headrotor/cm2/docs/cm2-render-big.png

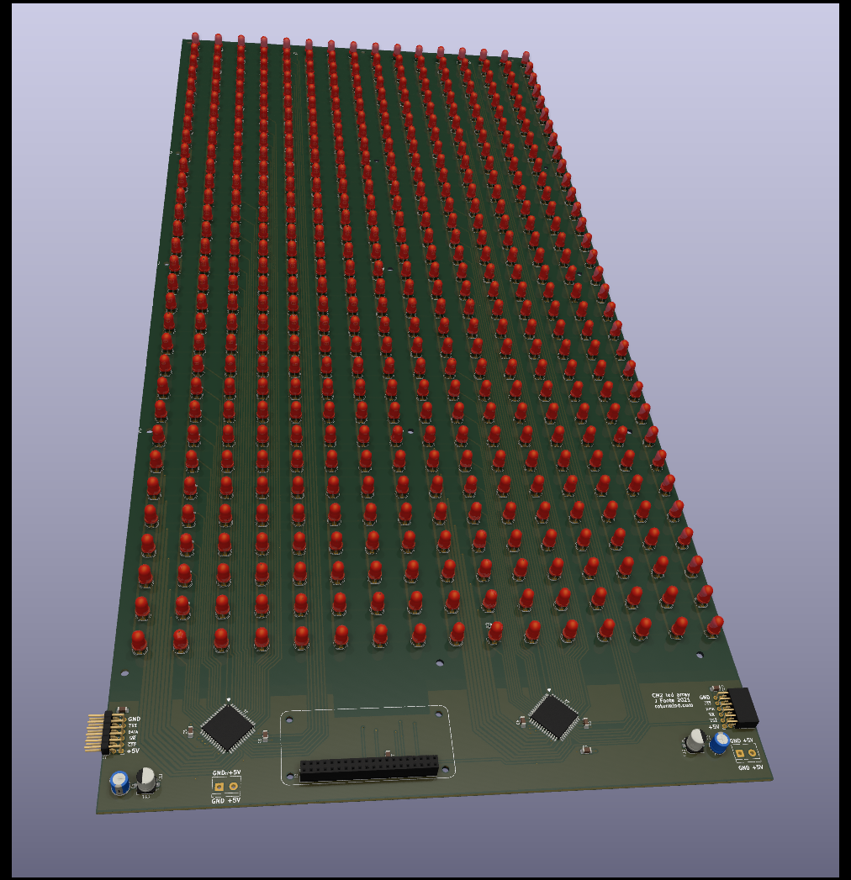
docs/cm2-render-big.png
