headrotor/cm2/README.md

# cm2
Design files for Connection Machine-inspired LED panel
