headrotor/cm2/docs/README.md

# cm2
Documentation files for Connection Machine-inspired LED panel

* `cm2-BOM.*`: Bill Of Materials, list of all parts necessary
* `cm2-pcb.pdf`  PDF of printed circuit board layout         
* `cm2-render.*` 3D renderings of printed circuit board with componentys    
* `pcb-cad-2D.dxf`  DXF of board outline with mounting holes
* `cm2-schematic.pdf` Board schematic in PDF format
* `cm2-dimensions.pdf`: Rendering of PCB with dimensions
* `ht1632cv120.pdf`: Data sheet of LED driver IC
