headrotor/cm2/sw/README.md

## CM2 panel Python software

Low-level driver code for the RPI is in `htlib` directory. See the README there. That code is compiled for the library `libht1632c-py.so` which must be in this directory or in the python load path. 

Several test programs exist to excercise the CM2 display panel. 'setxy.py' turns on a pixel at x and y, for example to turn on a pixel at x=10 and y=11 type:

```console
$ python setxy.py 10 11
```

## The CM2 HTTP Server

`cm2_server.py` drives the display by running an http server at port
8000 and responding to query strings in the URL of a GET request. Several command line options are available:

```
  -h, --help         show this help message and exit
  --silent           don't print anything to stdout
  --simulate         print a simulated screen to stdout
  --flip_horizontal  reverse horizontal direction, x=0 is at right
  --swap_xy          swap x and y directions, y is horizontal, x is vertical
  --flip_vertical    reverse vertical direction, y=0 is at bottom
```

To send a frame of data, send 128 characters of hexadecimal data in
column-major order with the `frame` query parameter.

Each 8 hex characters represent 32 bits in one column of LEDs. For
example the following curl command will send data to light the
leftmost and rightmost columns and top and bottom rows, drawing a box
around the perimeter of the display.

```console
$ curl -s 'http://cm2.local:8000/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'
```

Other query parameters are:

* `?bright=n` sets the PWM brightness where `n` is an integer between 0
  and 15.

* `?x=10&y=11&font=8x12&text=HELLO%20WORLD` will display the text
  "HELLO WORLD" (use URL string encoding) at position x=10 and y=11,
  using the `8x12` pixel font. If the `x` and `y` parameters are not
  specified the default position of zero (top left corner) is
  used. Negative positions can be used so that decrementing the `x`
  position will scroll the text left to right so that text wider than
  32 pixels can be displayed sequentially.

* `?clear=0` clears the display. This can be used with the `text`
  query to display text on a blank background. Note this only works with 
  the `text` command; to clear the display completely, send a `clear=0` 
  together with `text=%20` (space).

Several fonts are available, specified by character size as follows:

* 3x4num
* 4x5num
* 7x8num
* 4x6
* 4x6sym
* 5x8
* 6x8
* 7x12
* 8x12
* 12x16

A suffix of 'num' means that only numeric characters are available,
alphabetic characters will be rendered as an open rectangle. The font
selected by the `font` command is persistant and further `text`
commands will be rendered in that font.

As usual, multiple parameters may be used in one command, for example
the following command will display text at 10, 10 with a brightness of
25% on a dark background. 

```console
$ curl -s 'http://cm2.local:8000/?clear=0&x=10&y=10&bright=4&&text=Hello%20World'
```

### OSC_SERVER

A server using Open Sound Control uses UDP instead of HTTP and can be much faster (at the cost of missing frames).

This depends on https://pypi.org/project/python-osc/ and runs under python3.
python3 -m pip install python-osc
