headrotor/cm2/docs/cm2-BOM.xlsx

Ref | Qnty | Value | Description | Part Number/source | URL | Notes | Footprint | Description | Vendor
C1, C2 | 2 | 100uF | C_Polarized_Small_US |  |  | Alternate footprints: Only need C1 and C2 OR C11 and C12 | Capacitor_THT:CP_Radial_D6.3mm_P2.50mm | Polarized capacitor, small US symbol
C3, C4, C5, C6, C7, C8, C9, C10 | 8 | 1uF | CAP CER 1UF 25V X7R 1206 | CC1206KKX7R8BB105 | https://www.digikey.com/en/products/detail/yageo/CC1206KKX7R8BB105/2103094 |  | Capacitor_SMD:C_1206_3216Metric_Pad1.33x1.80mm_HandSolder | Unpolarized capacitor, small symbol
C11, C12 | 2 | 100uF | C_Polarized_Small_US |  |  | Alternate footprints: Only need C1 and C2 OR C11 and C12 | Capacitor_SMD:CP_Elec_6.3x7.7 | Polarized capacitor, small US symbol
D00A1–D31H2 | 512 |  | LED RED DIFFUSED T-1 3/4 T/H | SSL-LX5093SID | https://www.digikey.com/en/products/detail/lumex-opto-components-inc/SSL-LX5093SID/519349 | Suggest spectral center > 635nm (not HER) | LED_THT:LED_D5.0mm | Light emitting diode, small symbol, filled shape
J1 | 1 |  | 2.54mm pin header 2x06 right angle MALE |  |  | Need only 1 of J1 per 2 boards | Connector_PinSocket_2.54mm:PinSocket_2x06_P2.54mm_Horizontal | Generic connector, double row, 02x06, odd/even pin numbering scheme (row 1 odd numbers, row 2 even numbers), script generated (kicad-library-utils/schlib/autogen/connector/)
J2 | 1 |  | 2.54mm pin header 2x06 right angle FEMALE |  |  | Need only 1 of J2 per 2 boards | Connector_PinSocket_2.54mm:PinSocket_2x06_P2.54mm_Horizontal | Generic connector, double row, 02x06, odd/even pin numbering scheme (row 1 odd numbers, row 2 even numbers), script generated (kicad-library-utils/schlib/autogen/connector/)
J3 | 1 |  | 2,54mm pin hjeader 2x40 FEMALE |  |  | Socket for Rpi: need only 1 per set of 2 boards | Connector_PinSocket_2.54mm:PinSocket_2x20_P2.54mm_Vertical | expansion header for Raspberry Pi 2 & 3
J4, J5 | 2 |  | Screw_Terminal_01x02 5.08mm |  |  | Need only 1 per board | TerminalBlock:TerminalBlock_bornier-2_P5.08mm | Generic screw terminal, single row, 01x02, script generated (kicad-library-utils/schlib/autogen/connector/)
R1-R64 | 64 | R33 | RES SMD 33 OHM 5% 1/10W 0603 | CRCW060333R0JNEB | https://www.digikey.com/en/products/detail/vishay-dale/CRCW060333R0JNEB/5072151 |  | Resistor_SMD:R_0603_1608Metric_Pad0.98x0.95mm_HandSolder | Resistor, US symbol
U1, U2 | 2 | HT1632C-52LQFP | Holtek HT1632C LED Driver |  |  |  | Package_QFP:LQFP-52_14x14mm_P1mm | LED Matrix Driver, 32×8 or 24×16, 52-LQFP
RPI | 1 |  | Raspberry Pi Zero W | SC0510 | https://www.digikey.com/en/products/detail/raspberry-pi/SC0510/15298147 | Need only 1 per set of 2 boards
