headrotor/cm2/docs/pcb-cad-2D.dxf

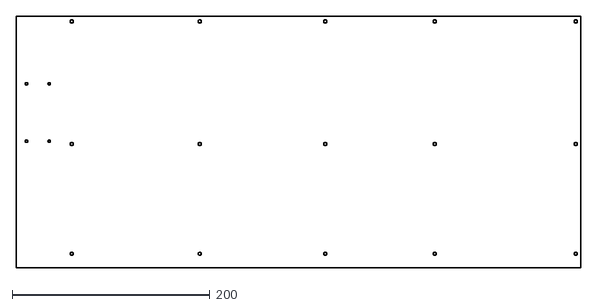
[picture p14: CAD file, 2021-12-01]
docs/pcb-cad-2D.dxf
571.1 x 254.0
