headrotor/cm2/docs/cm2-schematic.pdf

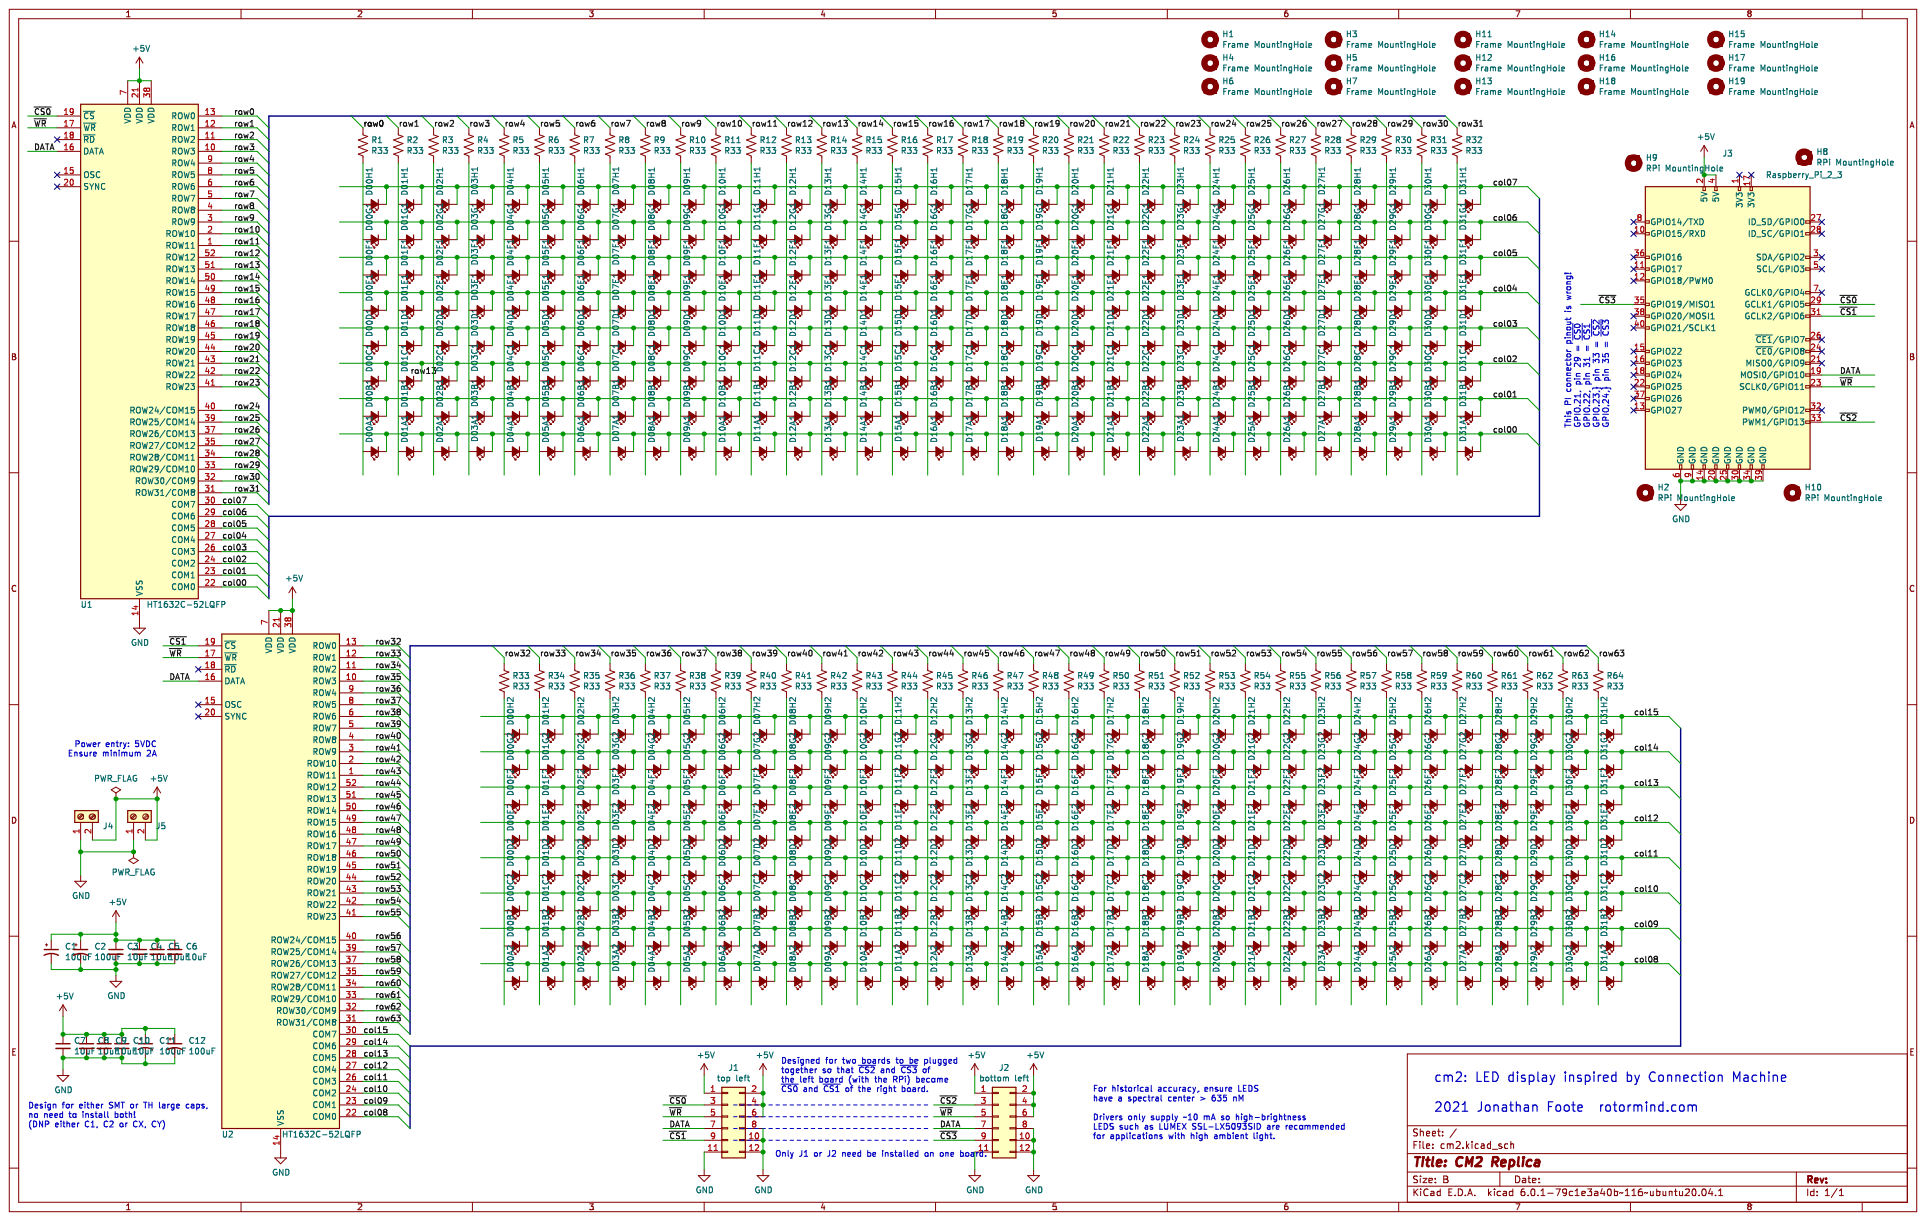
[picture p15: page 1]
