headrotor/cm2/docs/cm2-dimensions.pdf

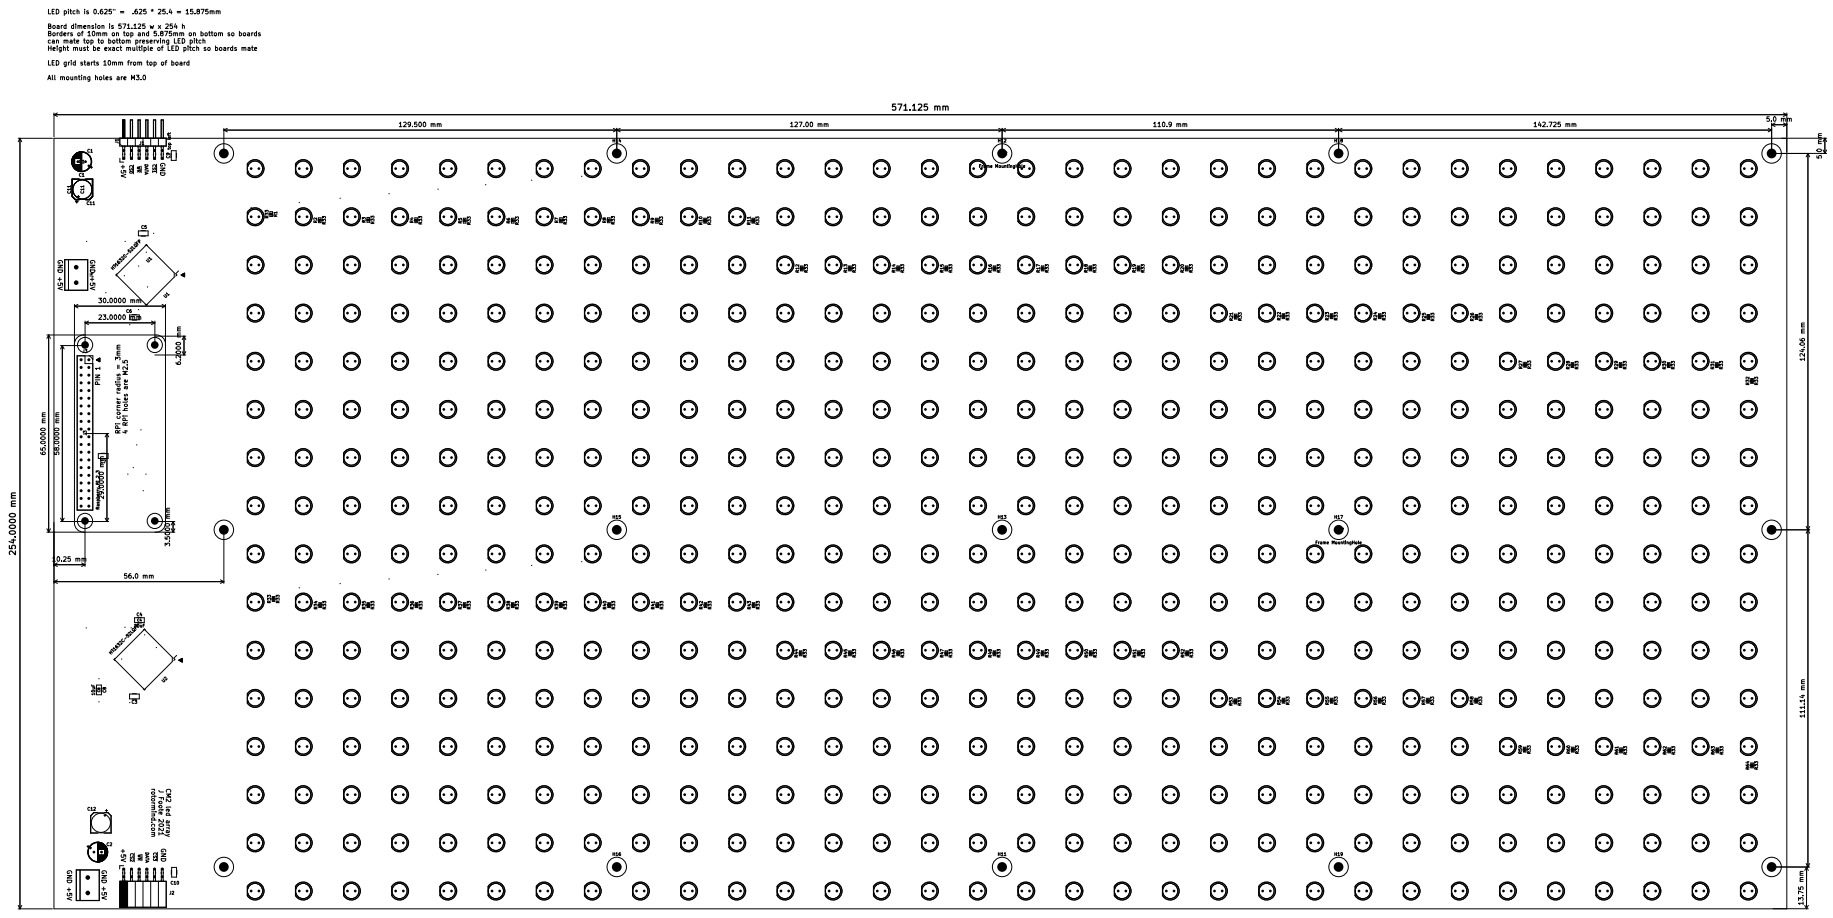
[picture p16: page 1]
