headrotor/cm2/docs/cm2-pcb.pdf

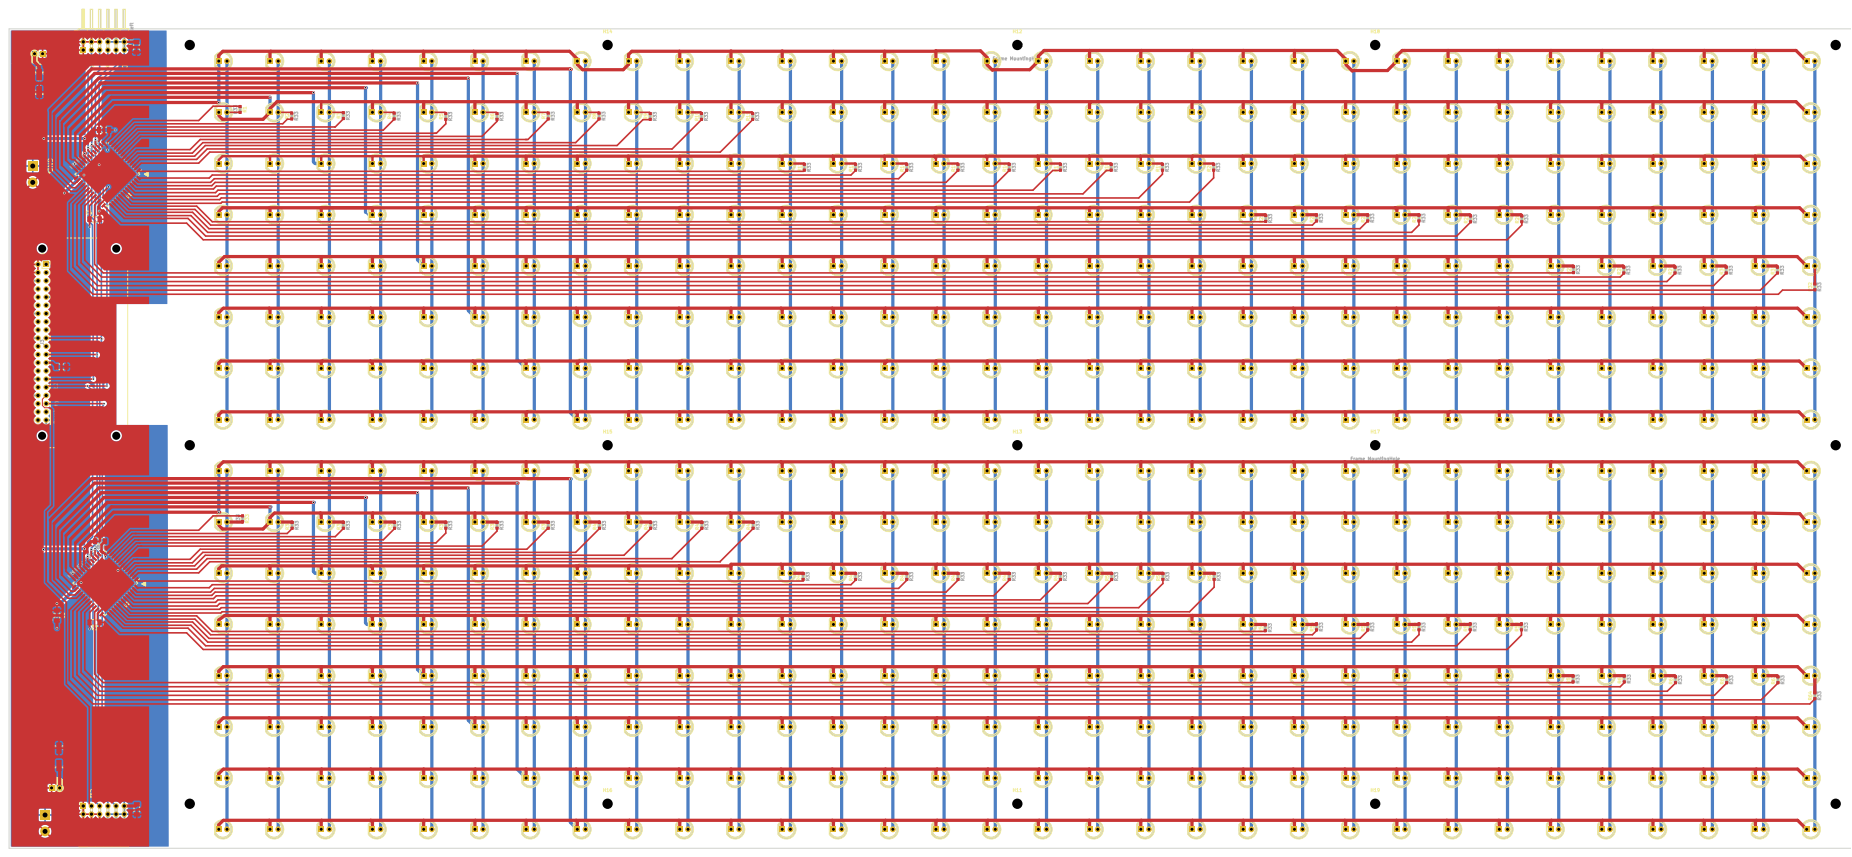
[picture p17: page 1]
