headrotor/cm2/pcb/cm2.kicad_pcb

## KiCad design pcb/cm2.kicad_pcb (2022-01-26)

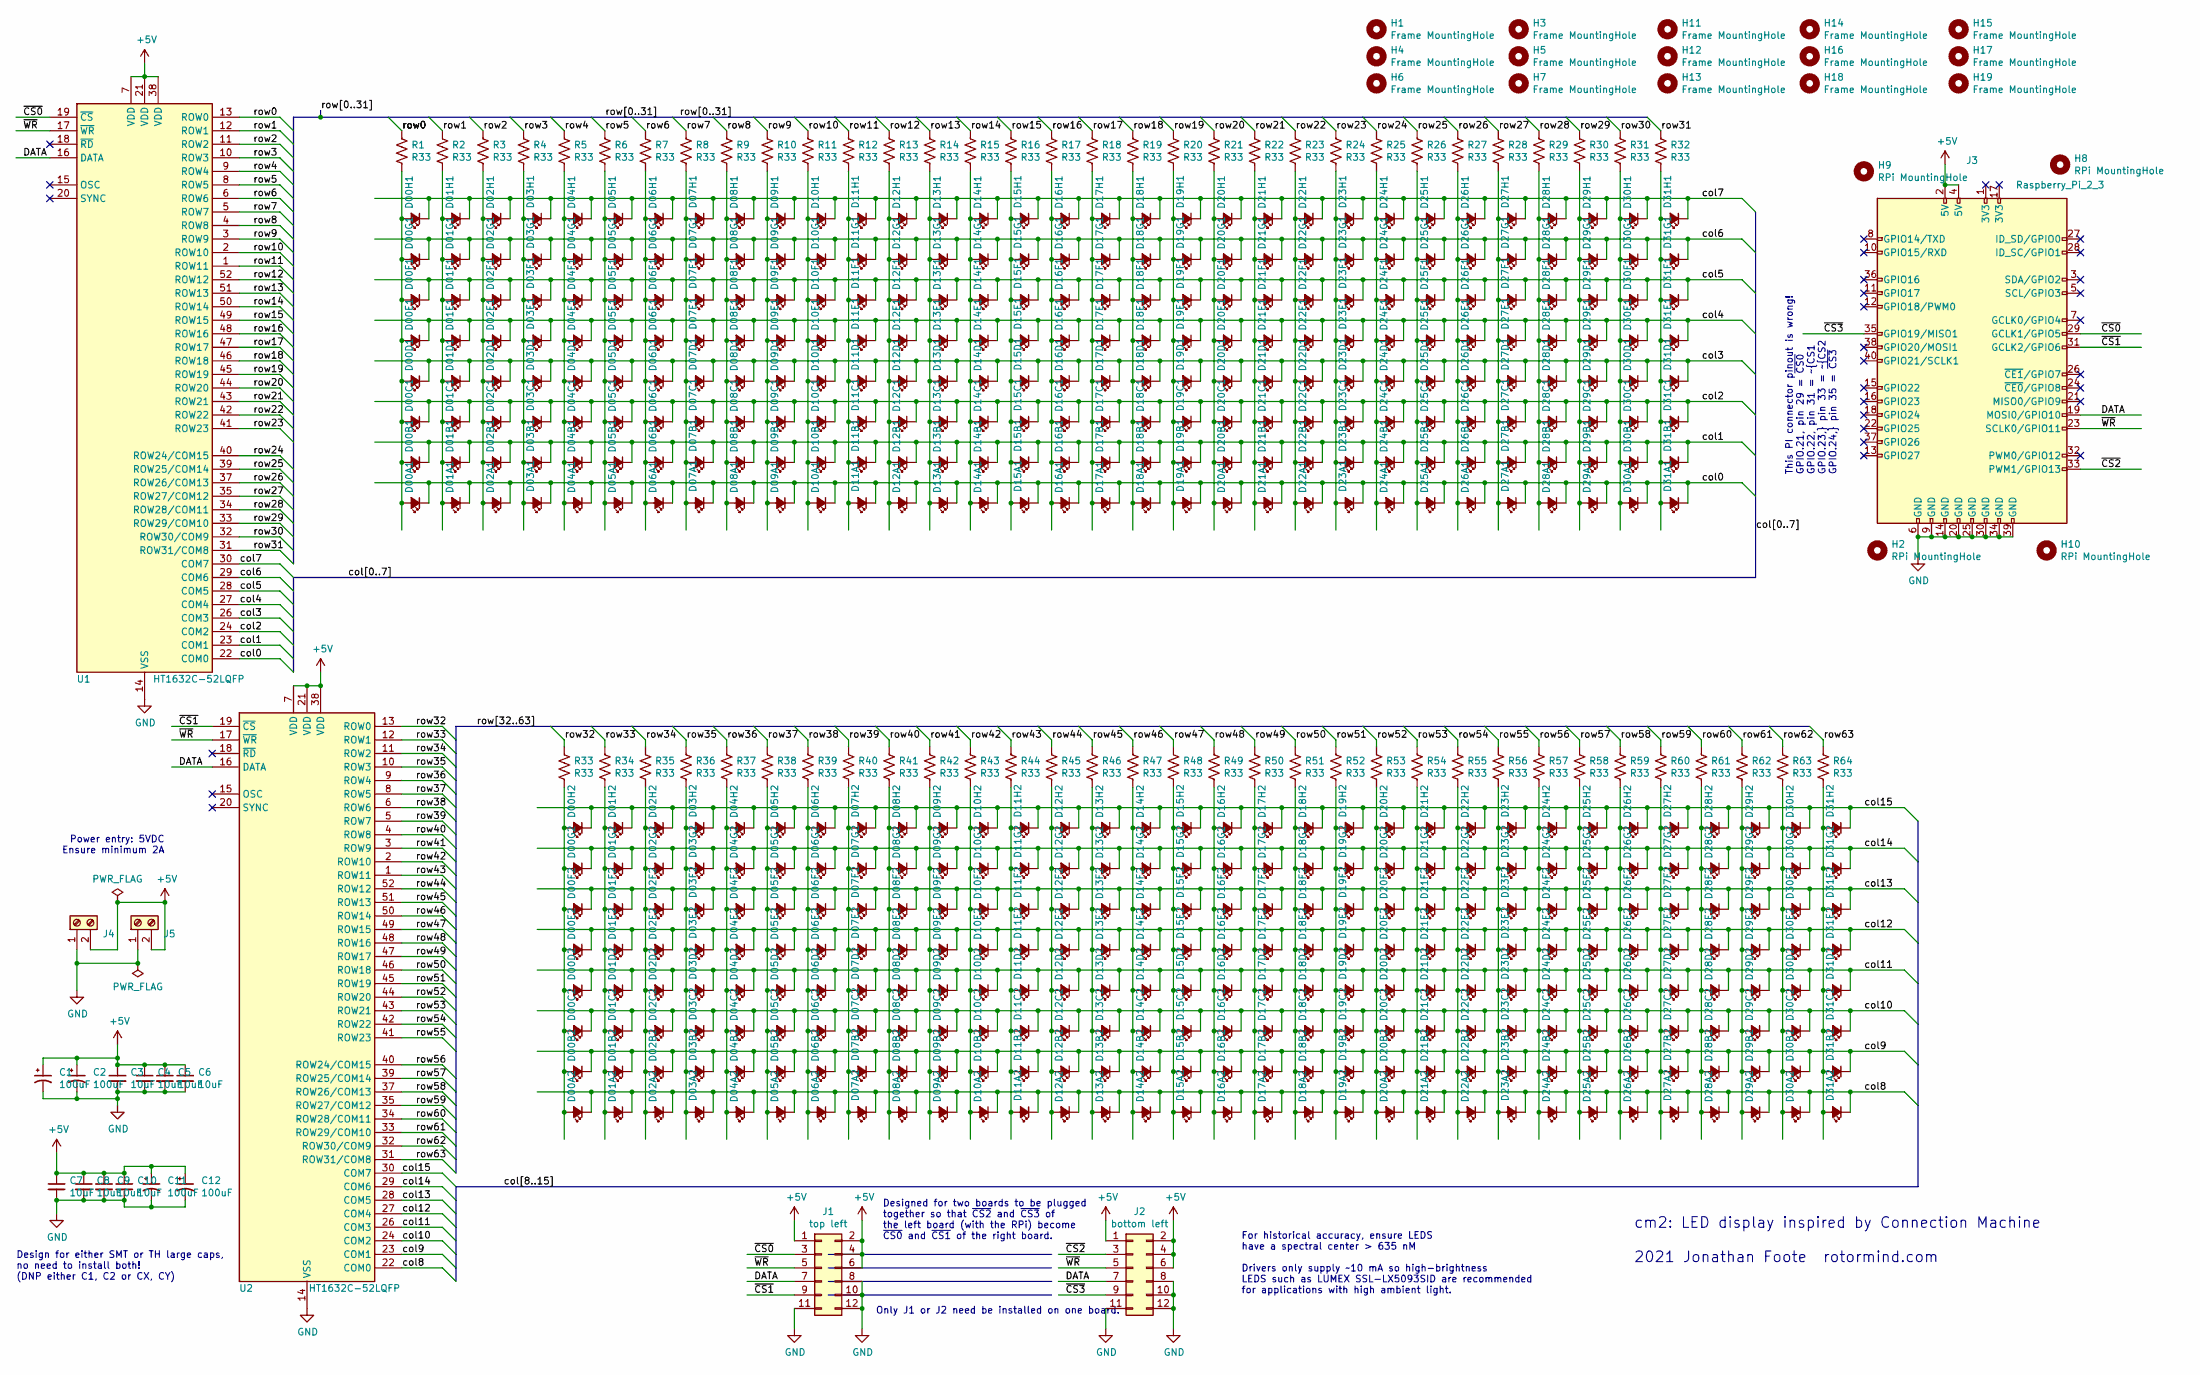
[picture p18: schematic cm2.kicad_sch, CM2 Replica]

Parts:
C1, C2: 100uF; CP_Radial_D6.3mm_P2.50mm
C3, C4, C5, C6, C7, C8, C9, C10: 10uF; C_1206_3216Metric_Pad1.33x1.80mm_HandSolder
C11, C12: 100uF; CP_Elec_6.3x7.7
D00A1, D00A2, D00B1, D00B2, D00C1, D00C2, D00D1, D00D2, D00E1, D00E2, D00F1, D00F2, D00G1, D00G2, D00H1, D00H2, D01A1, D01A2, D01B1, D01B2, D01C1, D01C2, D01D1, D01D2, D01E1, D01E2, D01F1, D01F2, D01G1, D01G2, D01H1, D01H2, D02A1, D02A2, D02B1, D02B2, D02C1, D02C2, D02D1, D02D2, D02E1, D02E2, D02F1, D02F2, D02G1, D02G2, D02H1, D02H2, D03A1, D03A2, D03B1, D03B2, D03C1, D03C2, D03D1, D03D2, D03E1, D03E2, D03F1, D03F2, D03G1, D03G2, D03H1, D03H2, D04A1, D04A2, D04B1, D04B2, D04C1, D04C2, D04D1, D04D2, D04E1, D04E2, D04F1, D04F2, D04G1, D04G2, D04H1, D04H2, D05A1, D05A2, D05B1, D05B2, D05C1, D05C2, D05D1, D05D2, D05E1, D05E2, D05F1, D05F2, D05G1, D05G2, D05H1, D05H2, D06A1, D06A2, D06B1, D06B2, D06C1, D06C2, D06D1, D06D2, D06E1, D06E2, D06F1, D06F2, D06G1, D06G2, D06H1, D06H2, D07A1, D07A2, D07B1, D07B2, D07C1, D07C2, D07D1, D07D2, D07E1, D07E2, D07F1, D07F2, D07G1, D07G2, D07H1, D07H2, D08A1, D08A2, D08B1, D08B2, D08C1, D08C2, D08D1, D08D2, D08E1, D08E2, D08F1, D08F2, D08G1, D08G2, D08H1, D08H2, D09A1, D09A2, D09B1, D09B2, D09C1, D09C2, D09D1, D09D2, D09E1, D09E2, D09F1, D09F2, D09G1, D09G2, D09H1, D09H2, D10A1, D10A2, D10B1, D10B2, D10C1, D10C2, D10D1, D10D2, D10E1, D10E2, D10F1, D10F2, D10G1, D10G2, D10H1, D10H2, D11A1, D11A2, D11B1, D11B2, D11C1, D11C2, D11D1, D11D2, D11E1, D11E2, D11F1, D11F2, D11G1, D11G2, D11H1, D11H2, D12A1, D12A2, D12B1, D12B2, D12C1, D12C2, D12D1, D12D2, D12E1, D12E2, D12F1, D12F2, D12G1, D12G2, D12H1, D12H2, D13A1, D13A2, D13B1, D13B2, D13C1, D13C2, D13D1, D13D2, D13E1, D13E2, D13F1, D13F2, D13G1, D13G2, D13H1, D13H2, D14A1, D14A2, D14B1, D14B2, D14C1, D14C2, D14D1, D14D2, D14E1, D14E2, D14F1, D14F2, D14G1, D14G2, D14H1, D14H2, D15A1, D15A2, D15B1, D15B2, D15C1, D15C2, D15D1, D15D2, D15E1, D15E2, D15F1, D15F2, D15G1, D15G2, D15H1, D15H2, D16A1, D16A2, D16B1, D16B2, D16C1, D16C2, D16D1, D16D2, D16E1, D16E2, D16F1, D16F2, D16G1, D16G2, D16H1, D16H2, D17A1, D17A2, D17B1, D17B2, D17C1, D17C2, D17D1, D17D2, D17E1, D17E2, D17F1, D17F2, D17G1, D17G2, D17H1, D17H2, D18A1, D18A2, D18B1, D18B2, D18C1, D18C2, D18D1, D18D2, D18E1, D18E2, D18F1, D18F2, D18G1, D18G2, D18H1, D18H2, D19A1, D19A2, D19B1, D19B2, D19C1, D19C2, D19D1, D19D2, D19E1, D19E2, D19F1, D19F2, D19G1, D19G2, D19H1, D19H2, D20A1, D20A2, D20B1, D20B2, D20C1, D20C2, D20D1, D20D2, D20E1, D20E2, D20F1, D20F2, D20G1, D20G2, D20H1, D20H2, D21A1, D21A2, D21B1, D21B2, D21C1, D21C2, D21D1, D21D2, D21E1, D21E2, D21F1, D21F2, D21G1, D21G2, D21H1, D21H2, D22A1, D22A2, D22B1, D22B2, D22C1, D22C2, D22D1, D22D2, D22E1, D22E2, D22F1, D22F2, D22G1, D22G2, D22H1, D22H2, D23A1, D23A2, D23B1, D23B2, D23C1, D23C2, D23D1, D23D2, D23E1, D23E2, D23F1, D23F2, D23G1, D23G2, D23H1, D23H2, D24A1, D24A2, D24B1, D24B2, D24C1, D24C2, D24D1, D24D2, D24E1, D24E2, D24F1, D24F2, D24G1, D24G2, D24H1, D24H2, D25A1, D25A2, D25B1, D25B2, D25C1, D25C2, D25D1, D25D2, D25E1, D25E2, D25F1, D25F2, D25G1, D25G2, D25H1, D25H2, D26A1, D26A2, D26B1, D26B2, D26C1, D26C2, D26D1, D26D2, D26E1, D26E2, D26F1, D26F2, D26G1, D26G2, D26H1, D26H2, D27A1, D27A2, D27B1, D27B2, D27C1, D27C2, D27D1, D27D2, D27E1, D27E2, D27F1, D27F2, D27G1, D27G2, D27H1, D27H2, D28A1, D28A2, D28B1, D28B2, D28C1, D28C2, D28D1, D28D2, D28E1, D28E2, D28F1, D28F2, D28G1, D28G2, D28H1, D28H2, D29A1, D29A2, D29B1, D29B2, D29C1, D29C2, D29D1, D29D2, D29E1, D29E2, D29F1, D29F2, D29G1, D29G2, D29H1, D29H2, D30A1, D30A2, D30B1, D30B2, D30C1, D30C2, D30D1, D30D2, D30E1, D30E2, D30F1, D30F2, D30G1, D30G2, D30H1, D30H2, D31A1, D31A2, D31B1, D31B2, D31C1, D31C2, D31D1, D31D2, D31E1, D31E2, D31F1, D31F2, D31G1, D31G2, D31H1, D31H2: LED_Small_ALT; LED_D5.0mm
H1, H3, H4, H5, H6, H7, H11, H12, H13, H14, H15, H16, H17, H18, H19: Frame MountingHole; MountingHole_3.2mm_M3
H2, H8, H9, H10: RPi MountingHole; MountingHole_2.5mm
J1: top left; PinHeader_2x06_P2.54mm_Horizontal
J2: bottom left; PinSocket_2x06_P2.54mm_Horizontal
J3: Raspberry_Pi_2_3; PinSocket_2x20_P2.54mm_Vertical
J4, J5: Screw_Terminal_01x02; TerminalBlock_bornier-2_P5.08mm
R1, R2, R3, R4, R5, R6, R7, R8, R9, R10, R11, R12, R13, R14, R15, R16, R17, R18, R19, R20, R21, R22, R23, R24, R25, R26, R27, R28, R29, R30, R31, R32, R33, R34, R35, R36, R37, R38, R39, R40, R41, R42, R43, R44, R45, R46, R47, R48, R49, R50, R51, R52, R53, R54, R55, R56, R57, R58, R59, R60, R61, R62, R63, R64: R33; R_0603_1608Metric_Pad0.98x0.95mm_HandSolder
U1, U2: HT1632C-52LQFP; LQFP-52_14x14mm_P1mm

Connections:
+5V: C1.1, C2.1, C3.1, C4.1, C5.1, C6.1, C7.1, C8.1, C9.1, C10.1, C11.1, C12.1, J1.1, J1.2, J1.4, J1.6, J2.1, J2.2, J2.4, J2.6, J3.2 (5V), J3.4 (5V), J4.2, J5.2, U1.7 (VDD), U1.21 (VDD), U1.38 (VDD), U2.7 (VDD), U2.21 (VDD), U2.38 (VDD); also elsewhere on the board
/DATA: J1.7, J2.7, J3.19 (MOSI0/GPIO10), U1.16 (DATA), U2.16 (DATA)
/col0: D00A1.1 (K), D01A1.1 (K), D02A1.1 (K), D03A1.1 (K), D04A1.1 (K), D05A1.1 (K), D06A1.1 (K), D07A1.1 (K), D08A1.1 (K), D09A1.1 (K), D10A1.1 (K), D11A1.1 (K), D12A1.1 (K), D13A1.1 (K), D14A1.1 (K), D15A1.1 (K), D16A1.1 (K), D17A1.1 (K), D18A1.1 (K), D19A1.1 (K), D20A1.1 (K), D21A1.1 (K), D22A1.1 (K), D23A1.1 (K), D24A1.1 (K), D25A1.1 (K), D26A1.1 (K), D27A1.1 (K), D28A1.1 (K), D29A1.1 (K), D30A1.1 (K), D31A1.1 (K), U1.22 (COM0)
/col1: D00B1.1 (K), D01B1.1 (K), D02B1.1 (K), D03B1.1 (K), D04B1.1 (K), D05B1.1 (K), D06B1.1 (K), D07B1.1 (K), D08B1.1 (K), D09B1.1 (K), D10B1.1 (K), D11B1.1 (K), D12B1.1 (K), D13B1.1 (K), D14B1.1 (K), D15B1.1 (K), D16B1.1 (K), D17B1.1 (K), D18B1.1 (K), D19B1.1 (K), D20B1.1 (K), D21B1.1 (K), D22B1.1 (K), D23B1.1 (K), D24B1.1 (K), D25B1.1 (K), D26B1.1 (K), D27B1.1 (K), D28B1.1 (K), D29B1.1 (K), D30B1.1 (K), D31B1.1 (K), U1.23 (COM1)
/col2: D00C1.1 (K), D01C1.1 (K), D02C1.1 (K), D03C1.1 (K), D04C1.1 (K), D05C1.1 (K), D06C1.1 (K), D07C1.1 (K), D08C1.1 (K), D09C1.1 (K), D10C1.1 (K), D11C1.1 (K), D12C1.1 (K), D13C1.1 (K), D14C1.1 (K), D15C1.1 (K), D16C1.1 (K), D17C1.1 (K), D18C1.1 (K), D19C1.1 (K), D20C1.1 (K), D21C1.1 (K), D22C1.1 (K), D23C1.1 (K), D24C1.1 (K), D25C1.1 (K), D26C1.1 (K), D27C1.1 (K), D28C1.1 (K), D29C1.1 (K), D30C1.1 (K), D31C1.1 (K), U1.24 (COM2)
/col3: D00D1.1 (K), D01D1.1 (K), D02D1.1 (K), D03D1.1 (K), D04D1.1 (K), D05D1.1 (K), D06D1.1 (K), D07D1.1 (K), D08D1.1 (K), D09D1.1 (K), D10D1.1 (K), D11D1.1 (K), D12D1.1 (K), D13D1.1 (K), D14D1.1 (K), D15D1.1 (K), D16D1.1 (K), D17D1.1 (K), D18D1.1 (K), D19D1.1 (K), D20D1.1 (K), D21D1.1 (K), D22D1.1 (K), D23D1.1 (K), D24D1.1 (K), D25D1.1 (K), D26D1.1 (K), D27D1.1 (K), D28D1.1 (K), D29D1.1 (K), D30D1.1 (K), D31D1.1 (K), U1.26 (COM3)
/col4: D00E1.1 (K), D01E1.1 (K), D02E1.1 (K), D03E1.1 (K), D04E1.1 (K), D05E1.1 (K), D06E1.1 (K), D07E1.1 (K), D08E1.1 (K), D09E1.1 (K), D10E1.1 (K), D11E1.1 (K), D12E1.1 (K), D13E1.1 (K), D14E1.1 (K), D15E1.1 (K), D16E1.1 (K), D17E1.1 (K), D18E1.1 (K), D19E1.1 (K), D20E1.1 (K), D21E1.1 (K), D22E1.1 (K), D23E1.1 (K), D24E1.1 (K), D25E1.1 (K), D26E1.1 (K), D27E1.1 (K), D28E1.1 (K), D29E1.1 (K), D30E1.1 (K), D31E1.1 (K), U1.27 (COM4)
/col5: D00F1.1 (K), D01F1.1 (K), D02F1.1 (K), D03F1.1 (K), D04F1.1 (K), D05F1.1 (K), D06F1.1 (K), D07F1.1 (K), D08F1.1 (K), D09F1.1 (K), D10F1.1 (K), D11F1.1 (K), D12F1.1 (K), D13F1.1 (K), D14F1.1 (K), D15F1.1 (K), D16F1.1 (K), D17F1.1 (K), D18F1.1 (K), D19F1.1 (K), D20F1.1 (K), D21F1.1 (K), D22F1.1 (K), D23F1.1 (K), D24F1.1 (K), D25F1.1 (K), D26F1.1 (K), D27F1.1 (K), D28F1.1 (K), D29F1.1 (K), D30F1.1 (K), D31F1.1 (K), U1.28 (COM5)
/col6: D00G1.1 (K), D01G1.1 (K), D02G1.1 (K), D03G1.1 (K), D04G1.1 (K), D05G1.1 (K), D06G1.1 (K), D07G1.1 (K), D08G1.1 (K), D09G1.1 (K), D10G1.1 (K), D11G1.1 (K), D12G1.1 (K), D13G1.1 (K), D14G1.1 (K), D15G1.1 (K), D16G1.1 (K), D17G1.1 (K), D18G1.1 (K), D19G1.1 (K), D20G1.1 (K), D21G1.1 (K), D22G1.1 (K), D23G1.1 (K), D24G1.1 (K), D25G1.1 (K), D26G1.1 (K), D27G1.1 (K), D28G1.1 (K), D29G1.1 (K), D30G1.1 (K), D31G1.1 (K), U1.29 (COM6)
/col7: D00H1.1 (K), D01H1.1 (K), D02H1.1 (K), D03H1.1 (K), D04H1.1 (K), D05H1.1 (K), D06H1.1 (K), D07H1.1 (K), D08H1.1 (K), D09H1.1 (K), D10H1.1 (K), D11H1.1 (K), D12H1.1 (K), D13H1.1 (K), D14H1.1 (K), D15H1.1 (K), D16H1.1 (K), D17H1.1 (K), D18H1.1 (K), D19H1.1 (K), D20H1.1 (K), D21H1.1 (K), D22H1.1 (K), D23H1.1 (K), D24H1.1 (K), D25H1.1 (K), D26H1.1 (K), D27H1.1 (K), D28H1.1 (K), D29H1.1 (K), D30H1.1 (K), D31H1.1 (K), U1.30 (COM7)
/col8: D00A2.1 (K), D01A2.1 (K), D02A2.1 (K), D03A2.1 (K), D04A2.1 (K), D05A2.1 (K), D06A2.1 (K), D07A2.1 (K), D08A2.1 (K), D09A2.1 (K), D10A2.1 (K), D11A2.1 (K), D12A2.1 (K), D13A2.1 (K), D14A2.1 (K), D15A2.1 (K), D16A2.1 (K), D17A2.1 (K), D18A2.1 (K), D19A2.1 (K), D20A2.1 (K), D21A2.1 (K), D22A2.1 (K), D23A2.1 (K), D24A2.1 (K), D25A2.1 (K), D26A2.1 (K), D27A2.1 (K), D28A2.1 (K), D29A2.1 (K), D30A2.1 (K), D31A2.1 (K), U2.22 (COM0)
/col9: D00B2.1 (K), D01B2.1 (K), D02B2.1 (K), D03B2.1 (K), D04B2.1 (K), D05B2.1 (K), D06B2.1 (K), D07B2.1 (K), D08B2.1 (K), D09B2.1 (K), D10B2.1 (K), D11B2.1 (K), D12B2.1 (K), D13B2.1 (K), D14B2.1 (K), D15B2.1 (K), D16B2.1 (K), D17B2.1 (K), D18B2.1 (K), D19B2.1 (K), D20B2.1 (K), D21B2.1 (K), D22B2.1 (K), D23B2.1 (K), D24B2.1 (K), D25B2.1 (K), D26B2.1 (K), D27B2.1 (K), D28B2.1 (K), D29B2.1 (K), D30B2.1 (K), D31B2.1 (K), U2.23 (COM1)
/col10: D00C2.1 (K), D01C2.1 (K), D02C2.1 (K), D03C2.1 (K), D04C2.1 (K), D05C2.1 (K), D06C2.1 (K), D07C2.1 (K), D08C2.1 (K), D09C2.1 (K), D10C2.1 (K), D11C2.1 (K), D12C2.1 (K), D13C2.1 (K), D14C2.1 (K), D15C2.1 (K), D16C2.1 (K), D17C2.1 (K), D18C2.1 (K), D19C2.1 (K), D20C2.1 (K), D21C2.1 (K), D22C2.1 (K), D23C2.1 (K), D24C2.1 (K), D25C2.1 (K), D26C2.1 (K), D27C2.1 (K), D28C2.1 (K), D29C2.1 (K), D30C2.1 (K), D31C2.1 (K), U2.24 (COM2)
/col11: D00D2.1 (K), D01D2.1 (K), D02D2.1 (K), D03D2.1 (K), D04D2.1 (K), D05D2.1 (K), D06D2.1 (K), D07D2.1 (K), D08D2.1 (K), D09D2.1 (K), D10D2.1 (K), D11D2.1 (K), D12D2.1 (K), D13D2.1 (K), D14D2.1 (K), D15D2.1 (K), D16D2.1 (K), D17D2.1 (K), D18D2.1 (K), D19D2.1 (K), D20D2.1 (K), D21D2.1 (K), D22D2.1 (K), D23D2.1 (K), D24D2.1 (K), D25D2.1 (K), D26D2.1 (K), D27D2.1 (K), D28D2.1 (K), D29D2.1 (K), D30D2.1 (K), D31D2.1 (K), U2.26 (COM3)
/col12: D00E2.1 (K), D01E2.1 (K), D02E2.1 (K), D03E2.1 (K), D04E2.1 (K), D05E2.1 (K), D06E2.1 (K), D07E2.1 (K), D08E2.1 (K), D09E2.1 (K), D10E2.1 (K), D11E2.1 (K), D12E2.1 (K), D13E2.1 (K), D14E2.1 (K), D15E2.1 (K), D16E2.1 (K), D17E2.1 (K), D18E2.1 (K), D19E2.1 (K), D20E2.1 (K), D21E2.1 (K), D22E2.1 (K), D23E2.1 (K), D24E2.1 (K), D25E2.1 (K), D26E2.1 (K), D27E2.1 (K), D28E2.1 (K), D29E2.1 (K), D30E2.1 (K), D31E2.1 (K), U2.27 (COM4)
/col13: D00F2.1 (K), D01F2.1 (K), D02F2.1 (K), D03F2.1 (K), D04F2.1 (K), D05F2.1 (K), D06F2.1 (K), D07F2.1 (K), D08F2.1 (K), D09F2.1 (K), D10F2.1 (K), D11F2.1 (K), D12F2.1 (K), D13F2.1 (K), D14F2.1 (K), D15F2.1 (K), D16F2.1 (K), D17F2.1 (K), D18F2.1 (K), D19F2.1 (K), D20F2.1 (K), D21F2.1 (K), D22F2.1 (K), D23F2.1 (K), D24F2.1 (K), D25F2.1 (K), D26F2.1 (K), D27F2.1 (K), D28F2.1 (K), D29F2.1 (K), D30F2.1 (K), D31F2.1 (K), U2.28 (COM5)
/col14: D00G2.1 (K), D01G2.1 (K), D02G2.1 (K), D03G2.1 (K), D04G2.1 (K), D05G2.1 (K), D06G2.1 (K), D07G2.1 (K), D08G2.1 (K), D09G2.1 (K), D10G2.1 (K), D11G2.1 (K), D12G2.1 (K), D13G2.1 (K), D14G2.1 (K), D15G2.1 (K), D16G2.1 (K), D17G2.1 (K), D18G2.1 (K), D19G2.1 (K), D20G2.1 (K), D21G2.1 (K), D22G2.1 (K), D23G2.1 (K), D24G2.1 (K), D25G2.1 (K), D26G2.1 (K), D27G2.1 (K), D28G2.1 (K), D29G2.1 (K), D30G2.1 (K), D31G2.1 (K), U2.29 (COM6)
/col15: D00H2.1 (K), D01H2.1 (K), D02H2.1 (K), D03H2.1 (K), D04H2.1 (K), D05H2.1 (K), D06H2.1 (K), D07H2.1 (K), D08H2.1 (K), D09H2.1 (K), D10H2.1 (K), D11H2.1 (K), D12H2.1 (K), D13H2.1 (K), D14H2.1 (K), D15H2.1 (K), D16H2.1 (K), D17H2.1 (K), D18H2.1 (K), D19H2.1 (K), D20H2.1 (K), D21H2.1 (K), D22H2.1 (K), D23H2.1 (K), D24H2.1 (K), D25H2.1 (K), D26H2.1 (K), D27H2.1 (K), D28H2.1 (K), D29H2.1 (K), D30H2.1 (K), D31H2.1 (K), U2.30 (COM7)
/row0: R1.1, U1.13 (ROW0)
/row1: R2.1, U1.12 (ROW1)
/row2: R3.1, U1.11 (ROW2)
/row3: R4.1, U1.10 (ROW3)
/row4: R5.1, U1.9 (ROW4)
/row5: R6.1, U1.8 (ROW5)
/row6: R7.1, U1.6 (ROW6)
/row7: R8.1, U1.5 (ROW7)
/row8: R9.1, U1.4 (ROW8)
/row9: R10.1, U1.3 (ROW9)
/row10: R11.1, U1.2 (ROW10)
/row11: R12.1, U1.1 (ROW11)
/row12: R13.1, U1.52 (ROW12)
/row13: R14.1, U1.51 (ROW13)
/row14: R15.1, U1.50 (ROW14)
/row15: R16.1, U1.49 (ROW15)
/row16: R17.1, U1.48 (ROW16)
/row17: R18.1, U1.47 (ROW17)
/row18: R19.1, U1.46 (ROW18)
/row19: R20.1, U1.45 (ROW19)
/row20: R21.1, U1.44 (ROW20)
/row21: R22.1, U1.43 (ROW21)
/row22: R23.1, U1.42 (ROW22)
/row23: R24.1, U1.41 (ROW23)
/row24: R25.1, U1.40 (ROW24/COM15)
/row25: R26.1, U1.39 (ROW25/COM14)
/row26: R27.1, U1.37 (ROW26/COM13)
/row27: R28.1, U1.35 (ROW27/COM12)
/row28: R29.1, U1.34 (ROW28/COM11)
/row29: R30.1, U1.33 (ROW29/COM10)
/row30: R31.1, U1.32 (ROW30/COM9)
/row31: R32.1, U1.31 (ROW31/COM8)
/row32: R33.1, U2.13 (ROW0)
/row33: R34.1, U2.12 (ROW1)
/row34: R35.1, U2.11 (ROW2)
/row35: R36.1, U2.10 (ROW3)
/row36: R37.1, U2.9 (ROW4)
/row37: R38.1, U2.8 (ROW5)
/row38: R39.1, U2.6 (ROW6)
/row39: R40.1, U2.5 (ROW7)
/row40: R41.1, U2.4 (ROW8)
/row41: R42.1, U2.3 (ROW9)
/row42: R43.1, U2.2 (ROW10)
/row43: R44.1, U2.1 (ROW11)
/row44: R45.1, U2.52 (ROW12)
/row45: R46.1, U2.51 (ROW13)
/row46: R47.1, U2.50 (ROW14)
/row47: R48.1, U2.49 (ROW15)
/row48: R49.1, U2.48 (ROW16)
/row49: R50.1, U2.47 (ROW17)
/row50: R51.1, U2.46 (ROW18)
/row51: R52.1, U2.45 (ROW19)
/row52: R53.1, U2.44 (ROW20)
/row53: R54.1, U2.43 (ROW21)
/row54: R55.1, U2.42 (ROW22)
/row55: R56.1, U2.41 (ROW23)
/row56: R57.1, U2.40 (ROW24/COM15)
/row57: R58.1, U2.39 (ROW25/COM14)
/row58: R59.1, U2.37 (ROW26/COM13)
/row59: R60.1, U2.35 (ROW27/COM12)
/row60: R61.1, U2.34 (ROW28/COM11)
/row61: R62.1, U2.33 (ROW29/COM10)
/row62: R63.1, U2.32 (ROW30/COM9)
/row63: R64.1, U2.31 (ROW31/COM8)
/~CS0: J1.3, J3.29 (GCLK1/GPIO5), U1.19 (~CS)
/~CS1: J1.9, J3.31 (GCLK2/GPIO6), U2.19 (~CS)
/~CS2: J2.3, J3.33 (PWM1/GPIO13)
/~CS3: J2.9, J3.35 (GPIO19/MISO1)
/~WR: J1.5, J2.5, J3.23 (SCLK0/GPIO11), U1.17 (~WR), U2.17 (~WR)
GND: C1.2, C2.2, C3.2, C4.2, C5.2, C6.2, C7.2, C8.2, C9.2, C10.2, C11.2, C12.2, J1.8, J1.10, J1.11, J1.12, J2.8, J2.10, J2.11, J2.12, J3.6 (GND), J3.9 (GND), J3.14 (GND), J3.20 (GND), J3.25 (GND), J3.30 (GND), J3.34 (GND), J3.39 (GND), J4.1, J5.1, U1.14 (VSS), U1.25 (VSS), U1.36 (VSS), U2.14 (VSS), U2.25 (VSS), U2.36 (VSS); also elsewhere on the board
unnamed: D00A1.2 (A), D00B1.2 (A), D00C1.2 (A), D00D1.2 (A), D00E1.2 (A), D00F1.2 (A), D00G1.2 (A), D00H1.2 (A), R1.2
unnamed: D00A2.2 (A), D00B2.2 (A), D00C2.2 (A), D00D2.2 (A), D00E2.2 (A), D00F2.2 (A), D00G2.2 (A), D00H2.2 (A), R33.2
unnamed: D01A1.2 (A), D01B1.2 (A), D01C1.2 (A), D01D1.2 (A), D01E1.2 (A), D01F1.2 (A), D01G1.2 (A), D01H1.2 (A), R2.2
unnamed: D01A2.2 (A), D01B2.2 (A), D01C2.2 (A), D01D2.2 (A), D01E2.2 (A), D01F2.2 (A), D01G2.2 (A), D01H2.2 (A), R34.2
unnamed: D02A1.2 (A), D02B1.2 (A), D02C1.2 (A), D02D1.2 (A), D02E1.2 (A), D02F1.2 (A), D02G1.2 (A), D02H1.2 (A), R3.2
unnamed: D02A2.2 (A), D02B2.2 (A), D02C2.2 (A), D02D2.2 (A), D02E2.2 (A), D02F2.2 (A), D02G2.2 (A), D02H2.2 (A), R35.2
unnamed: D03A1.2 (A), D03B1.2 (A), D03C1.2 (A), D03D1.2 (A), D03E1.2 (A), D03F1.2 (A), D03G1.2 (A), D03H1.2 (A), R4.2
unnamed: D03A2.2 (A), D03B2.2 (A), D03C2.2 (A), D03D2.2 (A), D03E2.2 (A), D03F2.2 (A), D03G2.2 (A), D03H2.2 (A), R36.2
unnamed: D04A1.2 (A), D04B1.2 (A), D04C1.2 (A), D04D1.2 (A), D04E1.2 (A), D04F1.2 (A), D04G1.2 (A), D04H1.2 (A), R5.2
unnamed: D05A1.2 (A), D05B1.2 (A), D05C1.2 (A), D05D1.2 (A), D05E1.2 (A), D05F1.2 (A), D05G1.2 (A), D05H1.2 (A), R6.2
unnamed: D06A1.2 (A), D06B1.2 (A), D06C1.2 (A), D06D1.2 (A), D06E1.2 (A), D06F1.2 (A), D06G1.2 (A), D06H1.2 (A), R7.2
unnamed: D07A1.2 (A), D07B1.2 (A), D07C1.2 (A), D07D1.2 (A), D07E1.2 (A), D07F1.2 (A), D07G1.2 (A), D07H1.2 (A), R8.2
unnamed: D08A1.2 (A), D08B1.2 (A), D08C1.2 (A), D08D1.2 (A), D08E1.2 (A), D08F1.2 (A), D08G1.2 (A), D08H1.2 (A), R9.2
unnamed: D08A2.2 (A), D08B2.2 (A), D08C2.2 (A), D08D2.2 (A), D08E2.2 (A), D08F2.2 (A), D08G2.2 (A), D08H2.2 (A), R41.2
unnamed: D09A2.2 (A), D09B2.2 (A), D09C2.2 (A), D09D2.2 (A), D09E2.2 (A), D09F2.2 (A), D09G2.2 (A), D09H2.2 (A), R42.2
unnamed: D09A1.2 (A), D09B1.2 (A), D09C1.2 (A), D09D1.2 (A), D09E1.2 (A), D09F1.2 (A), D09G1.2 (A), D09H1.2 (A), R10.2
unnamed: D10A2.2 (A), D10B2.2 (A), D10C2.2 (A), D10D2.2 (A), D10E2.2 (A), D10F2.2 (A), D10G2.2 (A), D10H2.2 (A), R43.2
unnamed: D10A1.2 (A), D10B1.2 (A), D10C1.2 (A), D10D1.2 (A), D10E1.2 (A), D10F1.2 (A), D10G1.2 (A), D10H1.2 (A), R11.2
unnamed: D11A2.2 (A), D11B2.2 (A), D11C2.2 (A), D11D2.2 (A), D11E2.2 (A), D11F2.2 (A), D11G2.2 (A), D11H2.2 (A), R44.2
unnamed: D11A1.2 (A), D11B1.2 (A), D11C1.2 (A), D11D1.2 (A), D11E1.2 (A), D11F1.2 (A), D11G1.2 (A), D11H1.2 (A), R12.2
unnamed: D12A1.2 (A), D12B1.2 (A), D12C1.2 (A), D12D1.2 (A), D12E1.2 (A), D12F1.2 (A), D12G1.2 (A), D12H1.2 (A), R13.2
unnamed: D12A2.2 (A), D12B2.2 (A), D12C2.2 (A), D12D2.2 (A), D12E2.2 (A), D12F2.2 (A), D12G2.2 (A), D12H2.2 (A), R45.2
unnamed: D13A1.2 (A), D13B1.2 (A), D13C1.2 (A), D13D1.2 (A), D13E1.2 (A), D13F1.2 (A), D13G1.2 (A), D13H1.2 (A), R14.2
unnamed: D14A1.2 (A), D14B1.2 (A), D14C1.2 (A), D14D1.2 (A), D14E1.2 (A), D14F1.2 (A), D14G1.2 (A), D14H1.2 (A), R15.2
unnamed: D14A2.2 (A), D14B2.2 (A), D14C2.2 (A), D14D2.2 (A), D14E2.2 (A), D14F2.2 (A), D14G2.2 (A), D14H2.2 (A), R47.2
unnamed: D15A2.2 (A), D15B2.2 (A), D15C2.2 (A), D15D2.2 (A), D15E2.2 (A), D15F2.2 (A), D15G2.2 (A), D15H2.2 (A), R48.2
unnamed: D15A1.2 (A), D15B1.2 (A), D15C1.2 (A), D15D1.2 (A), D15E1.2 (A), D15F1.2 (A), D15G1.2 (A), D15H1.2 (A), R16.2
unnamed: D16A1.2 (A), D16B1.2 (A), D16C1.2 (A), D16D1.2 (A), D16E1.2 (A), D16F1.2 (A), D16G1.2 (A), D16H1.2 (A), R17.2
unnamed: D16A2.2 (A), D16B2.2 (A), D16C2.2 (A), D16D2.2 (A), D16E2.2 (A), D16F2.2 (A), D16G2.2 (A), D16H2.2 (A), R49.2
unnamed: D17A1.2 (A), D17B1.2 (A), D17C1.2 (A), D17D1.2 (A), D17E1.2 (A), D17F1.2 (A), D17G1.2 (A), D17H1.2 (A), R18.2
unnamed: D18A1.2 (A), D18B1.2 (A), D18C1.2 (A), D18D1.2 (A), D18E1.2 (A), D18F1.2 (A), D18G1.2 (A), D18H1.2 (A), R19.2
unnamed: D18A2.2 (A), D18B2.2 (A), D18C2.2 (A), D18D2.2 (A), D18E2.2 (A), D18F2.2 (A), D18G2.2 (A), D18H2.2 (A), R51.2
unnamed: D19A1.2 (A), D19B1.2 (A), D19C1.2 (A), D19D1.2 (A), D19E1.2 (A), D19F1.2 (A), D19G1.2 (A), D19H1.2 (A), R20.2
unnamed: D19A2.2 (A), D19B2.2 (A), D19C2.2 (A), D19D2.2 (A), D19E2.2 (A), D19F2.2 (A), D19G2.2 (A), D19H2.2 (A), R52.2
unnamed: D20A2.2 (A), D20B2.2 (A), D20C2.2 (A), D20D2.2 (A), D20E2.2 (A), D20F2.2 (A), D20G2.2 (A), D20H2.2 (A), R53.2
unnamed: D20A1.2 (A), D20B1.2 (A), D20C1.2 (A), D20D1.2 (A), D20E1.2 (A), D20F1.2 (A), D20G1.2 (A), D20H1.2 (A), R21.2
unnamed: D21A2.2 (A), D21B2.2 (A), D21C2.2 (A), D21D2.2 (A), D21E2.2 (A), D21F2.2 (A), D21G2.2 (A), D21H2.2 (A), R54.2
unnamed: D22A1.2 (A), D22B1.2 (A), D22C1.2 (A), D22D1.2 (A), D22E1.2 (A), D22F1.2 (A), D22G1.2 (A), D22H1.2 (A), R23.2
unnamed: D22A2.2 (A), D22B2.2 (A), D22C2.2 (A), D22D2.2 (A), D22E2.2 (A), D22F2.2 (A), D22G2.2 (A), D22H2.2 (A), R55.2
unnamed: D23A2.2 (A), D23B2.2 (A), D23C2.2 (A), D23D2.2 (A), D23E2.2 (A), D23F2.2 (A), D23G2.2 (A), D23H2.2 (A), R56.2
unnamed: D25A2.2 (A), D25B2.2 (A), D25C2.2 (A), D25D2.2 (A), D25E2.2 (A), D25F2.2 (A), D25G2.2 (A), D25H2.2 (A), R58.2
unnamed: D26A1.2 (A), D26B1.2 (A), D26C1.2 (A), D26D1.2 (A), D26E1.2 (A), D26F1.2 (A), D26G1.2 (A), D26H1.2 (A), R27.2
unnamed: D27A1.2 (A), D27B1.2 (A), D27C1.2 (A), D27D1.2 (A), D27E1.2 (A), D27F1.2 (A), D27G1.2 (A), D27H1.2 (A), R28.2
unnamed: D27A2.2 (A), D27B2.2 (A), D27C2.2 (A), D27D2.2 (A), D27E2.2 (A), D27F2.2 (A), D27G2.2 (A), D27H2.2 (A), R60.2
unnamed: D28A1.2 (A), D28B1.2 (A), D28C1.2 (A), D28D1.2 (A), D28E1.2 (A), D28F1.2 (A), D28G1.2 (A), D28H1.2 (A), R29.2
unnamed: D28A2.2 (A), D28B2.2 (A), D28C2.2 (A), D28D2.2 (A), D28E2.2 (A), D28F2.2 (A), D28G2.2 (A), D28H2.2 (A), R61.2
unnamed: D29A1.2 (A), D29B1.2 (A), D29C1.2 (A), D29D1.2 (A), D29E1.2 (A), D29F1.2 (A), D29G1.2 (A), D29H1.2 (A), R30.2
unnamed: D29A2.2 (A), D29B2.2 (A), D29C2.2 (A), D29D2.2 (A), D29E2.2 (A), D29F2.2 (A), D29G2.2 (A), D29H2.2 (A), R62.2
unnamed: D30A1.2 (A), D30B1.2 (A), D30C1.2 (A), D30D1.2 (A), D30E1.2 (A), D30F1.2 (A), D30G1.2 (A), D30H1.2 (A), R31.2
unnamed: D31A1.2 (A), D31B1.2 (A), D31C1.2 (A), D31D1.2 (A), D31E1.2 (A), D31F1.2 (A), D31G1.2 (A), D31H1.2 (A), R32.2
unnamed: D21A1.2 (A), D21B1.2 (A), D21C1.2 (A), D21D1.2 (A), D21E1.2 (A), D21F1.2 (A), D21G1.2 (A), D21H1.2 (A), R22.2
unnamed: D23A1.2 (A), D23B1.2 (A), D23C1.2 (A), D23D1.2 (A), D23E1.2 (A), D23F1.2 (A), D23G1.2 (A), D23H1.2 (A), R24.2
unnamed: D24A1.2 (A), D24B1.2 (A), D24C1.2 (A), D24D1.2 (A), D24E1.2 (A), D24F1.2 (A), D24G1.2 (A), D24H1.2 (A), R25.2
unnamed: D25A1.2 (A), D25B1.2 (A), D25C1.2 (A), D25D1.2 (A), D25E1.2 (A), D25F1.2 (A), D25G1.2 (A), D25H1.2 (A), R26.2
unnamed: D04A2.2 (A), D04B2.2 (A), D04C2.2 (A), D04D2.2 (A), D04E2.2 (A), D04F2.2 (A), D04G2.2 (A), D04H2.2 (A), R37.2
unnamed: D05A2.2 (A), D05B2.2 (A), D05C2.2 (A), D05D2.2 (A), D05E2.2 (A), D05F2.2 (A), D05G2.2 (A), D05H2.2 (A), R38.2
unnamed: D06A2.2 (A), D06B2.2 (A), D06C2.2 (A), D06D2.2 (A), D06E2.2 (A), D06F2.2 (A), D06G2.2 (A), D06H2.2 (A), R39.2
unnamed: D07A2.2 (A), D07B2.2 (A), D07C2.2 (A), D07D2.2 (A), D07E2.2 (A), D07F2.2 (A), D07G2.2 (A), D07H2.2 (A), R40.2
unnamed: D13A2.2 (A), D13B2.2 (A), D13C2.2 (A), D13D2.2 (A), D13E2.2 (A), D13F2.2 (A), D13G2.2 (A), D13H2.2 (A), R46.2
unnamed: D17A2.2 (A), D17B2.2 (A), D17C2.2 (A), D17D2.2 (A), D17E2.2 (A), D17F2.2 (A), D17G2.2 (A), D17H2.2 (A), R50.2
unnamed: D24A2.2 (A), D24B2.2 (A), D24C2.2 (A), D24D2.2 (A), D24E2.2 (A), D24F2.2 (A), D24G2.2 (A), D24H2.2 (A), R57.2
unnamed: D26A2.2 (A), D26B2.2 (A), D26C2.2 (A), D26D2.2 (A), D26E2.2 (A), D26F2.2 (A), D26G2.2 (A), D26H2.2 (A), R59.2
unnamed: D30A2.2 (A), D30B2.2 (A), D30C2.2 (A), D30D2.2 (A), D30E2.2 (A), D30F2.2 (A), D30G2.2 (A), D30H2.2 (A), R63.2
unnamed: D31A2.2 (A), D31B2.2 (A), D31C2.2 (A), D31D2.2 (A), D31E2.2 (A), D31F2.2 (A), D31G2.2 (A), D31H2.2 (A), R64.2

Notes on the sheet:
For historical accuracy, ensure LEDS have a spectral center > 635 nM Drivers only supply ~10 mA so high-brightness LEDS such as LUMEX SSL-LX5093SID are recommended for applications with high ambient light.
Designed for two boards to be plugged together so that ~{CS2} and ~{CS3} of the left board (with the RPi) become ~{CS0} and ~{CS1} of the right board.
Power entry: 5VDC Ensure minimum 2A
cm2: LED display inspired by Connection Machine 2021 Jonathan Foote rotormind.com
This PI connector pinout is wrong! GPIO.21, pin 29 = ~{CS0} GPIO.22, pin 31 = ~{CS1 GPIO.23,} pin 33 = ~{CS2 GPIO.24,} pin 35 = ~{CS3}
Only J1 or J2 need be installed on one board.
Design for either SMT or TH large caps, no need to install both! (DNP either C1, C2 or CX, CY)

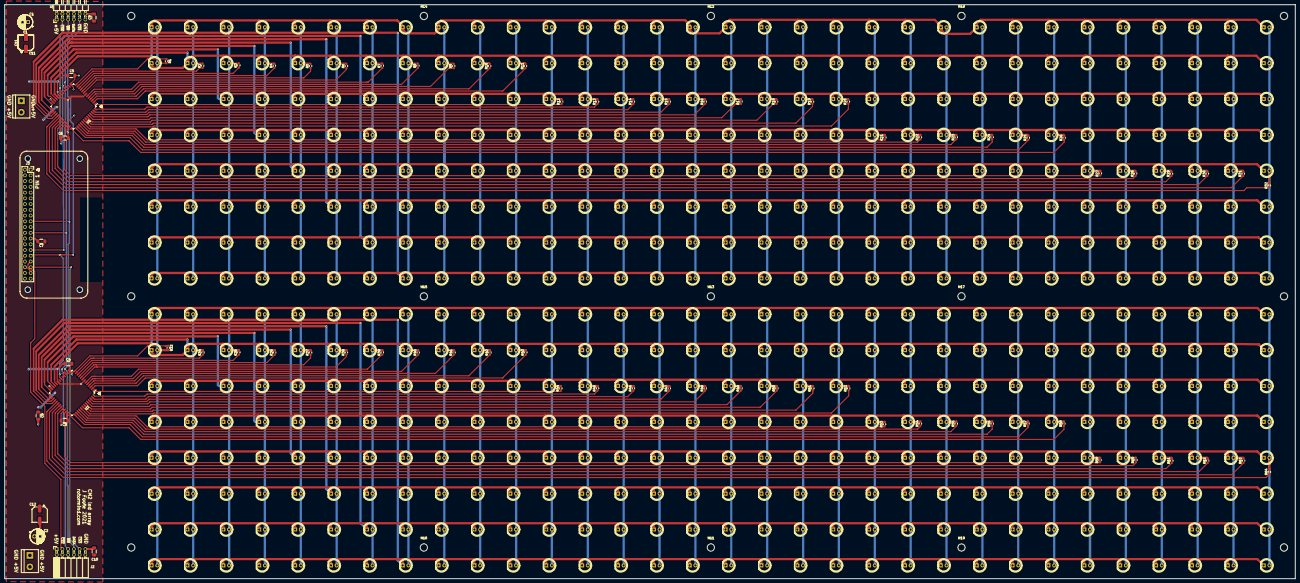
[picture p19: board cm2.kicad_pcb from above]

Board: 2 copper layers, 571.1 x 254.0 mm, 618 parts (0 on the bottom side), 152 nets.

Other parts of the board:
C1#2, C2#2: 100uF; CP_Radial_D6.3mm_P2.50mm
C11#2, C12#2: 100uF; CP_Elec_6.3x7.7

Their connections:
+5V: C1#2.1, C2#2.1, C11#2.1, C12#2.1; also elsewhere on the board
GND: C1#2.2, C2#2.2, C11#2.2, C12#2.2; also elsewhere on the board
