headrotor/cm2/(commit log)

2021-05-11 first add
    [cm2.sch]
2021-05-12 added python script for pcb array
    [cm2.kicad_pcb]
2021-07-28 continue wiring -- 3hr
    [cm2.kicad_pcb, cm2.sch]
2021-08-07 wiring, mpunting holes, 3h
    [cm2.kicad_pcb, cm2.sch]
2021-08-24 get rpi dimensions exact, rerout chip selects, 2 hrs
    [cm2.kicad_pcb, cm2.sch]
2021-08-31 Final board check, tape out, and submit. 3hrs
    [cm2.kicad_pcb, cm2.sch]
2021-11-09 Add brightness test and frame timing benchmarks
2021-11-12 add hexframe method to send hex frame data
2021-11-13 different libs for servertest
    [cm2.kicad_pcb, cm2.sch]
2021-12-01 added CAD files
    [cm2.kicad_pcb, pcb-cad-2D.dxf]
2022-01-11 update for Kicad version 6
    [cm2-v6.kicad_pcb, cm2-v6.kicad_sch]
2022-01-24 reorg file tree
    [cm2.kicad_pcb, cm2.kicad_sch]
2022-01-24 update to v6.0
    [cm2.kicad_pcb, cm2.kicad_sch]
2022-01-24 fix errors from v6 conversion
    [cm2.kicad_pcb, cm2.kicad_sch, pcb-cad-2D.dxf]
2022-01-24 added BOM files
    [cm2-BOM.csv, cm2-BOM.xlsx]
2022-01-26 added more docs
    [cm2-BOM.xlsx, cm2.kicad_pcb, pcb-cad-2D.dxf]
